waistarek/feel-the-music-arduino/(commit log)

2025-10-02 Fix: Bildlinks (.JPEG→.jpeg) und GIF-Name aktualisiert
2026-10-18 docs: improve Arduino music prototype README for portfolio
2026-10-18 docs: redesign Arduino demo landing page
